k4kfh/turningTables/(list of files, drawings)

Other design files:
Circuit Sketch.fzz
