k4kfh/turningTables/(commit log)

2016-01-06 Adding already-done Arduino sketch with basic rotation functions
2016-02-10 Commit for use on layout PC
    I dont know what this contains I just need to sync it to the layout laptop
    [Circuit Sketch.fzz]
2016-06-25 Removing bogus circuit sketch, adding new functional sketch
    This is the start of a new chapter in this project's development. I just tested the mechanism for the first time, and it works. The sketch has basic functionality EXCEPT that it has no interface to JMRI, and it has no calibration/memory system, so it's VERY easy to mess up the positioning, and the only way to fix that is to open up the mechanism and tune it back into place.
    [Circuit Sketch.fzz]
2016-06-26 Working on calibration/service mode a little more
    Added support for:
    - Piezo beeper (plays startup sound and sounds on shutdown)
    - Service alignment buttons (moves one gear turn, not 5) - bonus: uses no interrupts!
2016-06-26 Reorganizing, half-started CMRI interface
    Arduino IDE insisted I save the .ino file in a folder that matched, so I obliged (mostly to shut it up). I also started the very beginning of a CMRI interface, but did not have time to do any kind of testing or even finish a simple test sketch. The program is probably not going to compile correctly right now, or at the very least it won't run correctly.
    Other than that, no changes since last commit.
    [turningTables.ino]
2016-06-26 Beginnings of other rotation modes
    I started work on the other rotation modes (full 180, forced counterclockwise, and forced clockwise). Right now, this hasn't been tested because I'm committing without an Arduino handy to test it on, but everything SHOULD work okay, with a few minor bugs probably in there somewhere. I also added some better commenting, and a proper header with title, description, and credits.
    [turningTables.ino]
2016-07-04 Reverted back to no CMRI interface for reliability tests on the sensor
    [turningTables.ino]
2016-07-05 Reliability fix, removed CMRI interface temporarily for debugging
    I have removed the CMRI interface code temporarily as I implemented a reliability improvement. Sometimes, the hall effect sensor would trigger almost immediately when the motor started (since the magnet stopped almost directly above it), which isn't supposed to happen. So it would mess up the gear turn count. I added a time-based detection system for when that happens so that the Arduino notices when it's triggered unusually fast, and ignores it. I did a fairly lengthy test (about 10 minutes solid) and had no alignment issues at all, so I'm calling this fixed.
    [turningTables.ino]
2016-07-05 Removing temporary debugging Serial.println() functions
    Just a quick commit to remove these before starting on the CMRI interface again.
2016-07-05 Adding EEPROM position recall functionality
    Now whenever the turntable rotates, it writes the position to the EEPROM. Whenever the Arduino boots, in setup() it grabs the position out of the EEPROM, so it will never forget where it is positioned unless it is stopped mid-movement.
2016-07-10 Committing half-working CMRI interface for use in an ArduinoCMRI issue
    The low-level electromechanical part of the turntable is pretty much complete. There is rarely (if ever) an alignment error, and most of the ones that do come up are probably due to a buggy PC interface. I am making this commit so that I can access the sketch from GitHub and discuss it in issues.
    [turningTables.ino]
2016-07-13 Functional non-blocking rotation system and 180 degree rotate function
    This commit is by no means a "polished" finished product, but it is a big step forward in development. Everything has been rewritten (aside from startup_beep() ) to be completely non-blocking, thus fixing the errors in the JMRI console. Also, in tinkering with the "rotate 180 degrees" function, I found out that for some reason turn_cw() and turn_ccw() dislike the number 12. If I simply set the targetGearTurns to 60 (12*5), the program works. I'm not calling that a permanent solution, but it is a step in the right direction and it works for now. I plan on polishing up the user-editable configuration variables at the top, a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
    [turningTables.ino]
2016-07-19 Cleaning up the top of the file
    I tidied up the #define statements, const int definitions, and some other misc. stuff to make it a little more readable for the end user. It is configured for an Atlas HO turntable in its current state.
